dl9lj/pa/pics/PA6.jpg

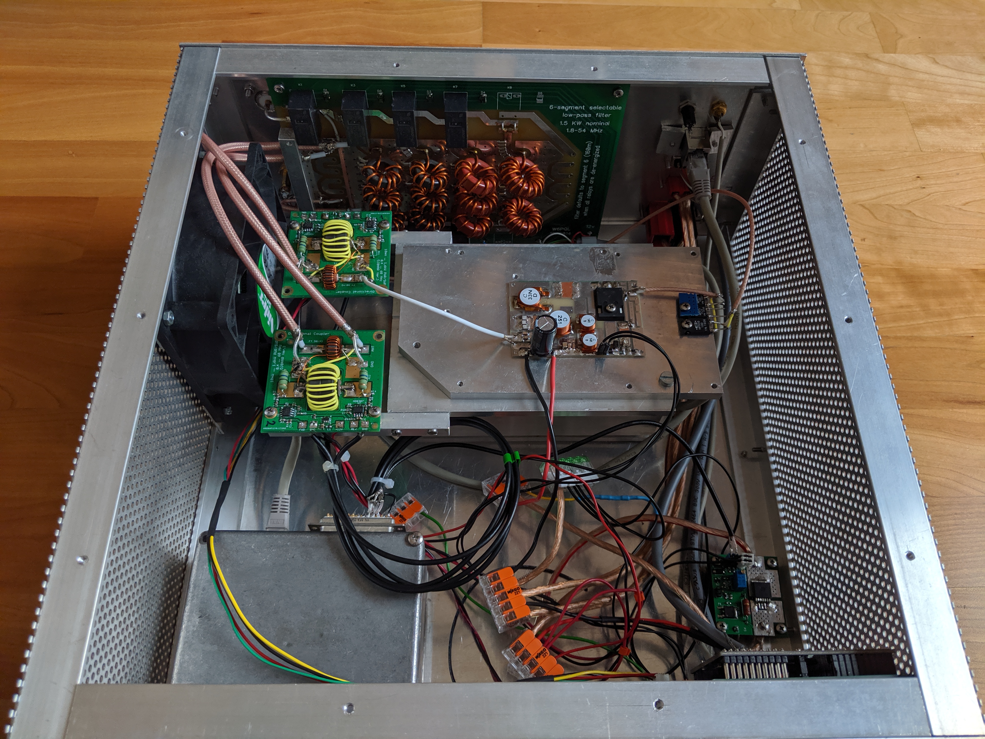
pics/PA6.jpg
