dl9lj/pa/kicad/sequencer.pdf

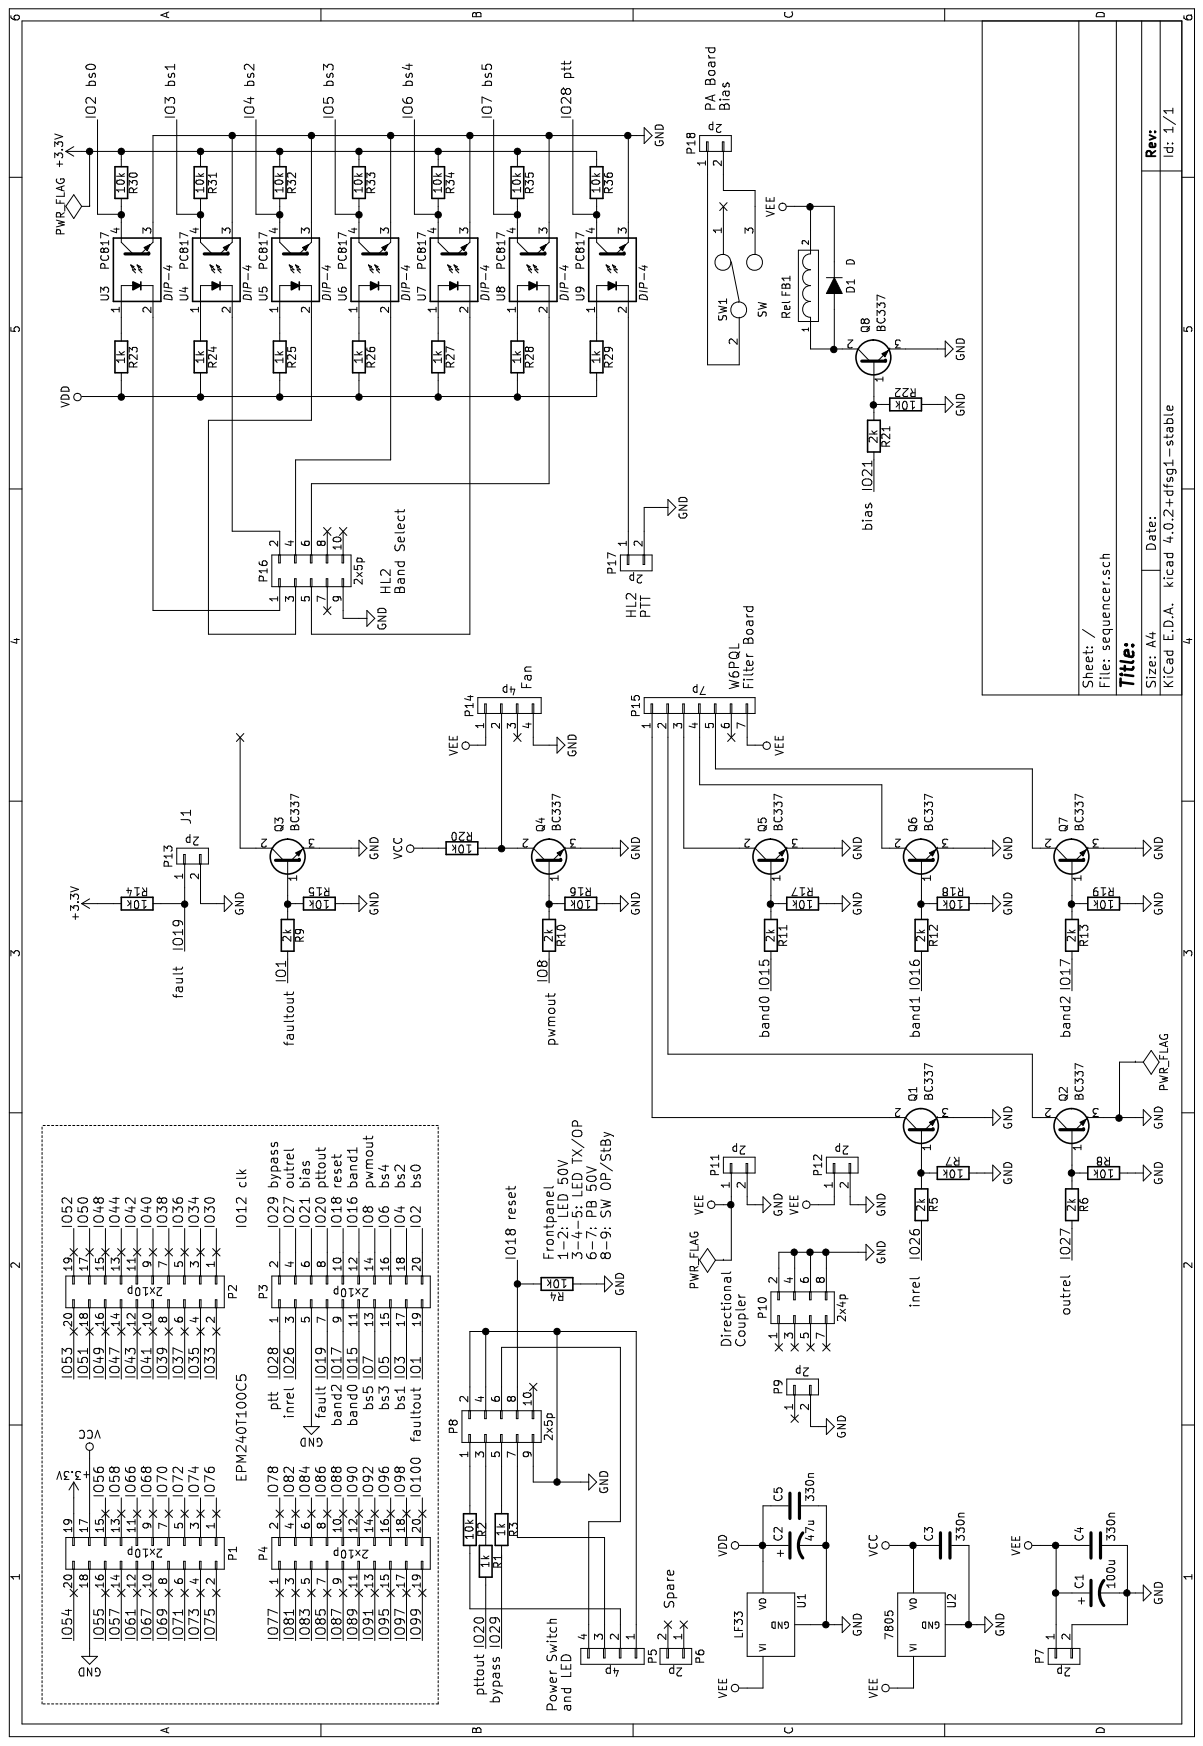
[picture p15: page 1]
