dl9lj/pa/kicad/sequencer.sch

## KiCad design kicad/sequencer.sch (2019-10-23)

Schematic: sequencer.sch

Parts:
C1: 100u
C2: 47u
C3, C4, C5: 330n
D1: D
FB1: Rel
P1, P2, P3, P4: 2x10p
P5, P14: 4p
P6, P7, P9, P11, P12, P13, P17, P18: 2p
P8, P16: 2x5p
P10: 2x4p
P15: 7p
Q1, Q2, Q3, Q4, Q5, Q6, Q7, Q8: BC337
R1, R3, R23, R24, R25, R26, R27, R28, R29: 1k
R2, R4, R7, R8, R14, R15, R16, R17, R18, R19, R20, R22, R30, R31, R32, R33, R34, R35, R36: 10k
R5, R6, R9, R10, R11, R12, R13, R21: 2k
SW1: SW
U1: LF33
U2: 7805
U3, U4, U5, U6, U7, U8, U9: PC817; DIP-4

Notes on the sheet:
EPM240T100C5
bias
bs0
bs1
bs2
bs3
bs4
bs5
ptt
pwmout
band0
band1
band2
outrel
inrel
faultout
reset
bypass
pttout
IO12 clk
fault
Frontpanel 1-2: LED 50V 3-4-5: LED TX/OP 6-7: PB 50V 8-9: SW OP/StBy
Fan
HL2 Band Select
HL2 PTT
PA Board Bias
W6PQL Filter Board
Directional Coupler
Spare
Power Switch and LED
